chedinhtrung/RavenFC/images/5Vripples.jpg

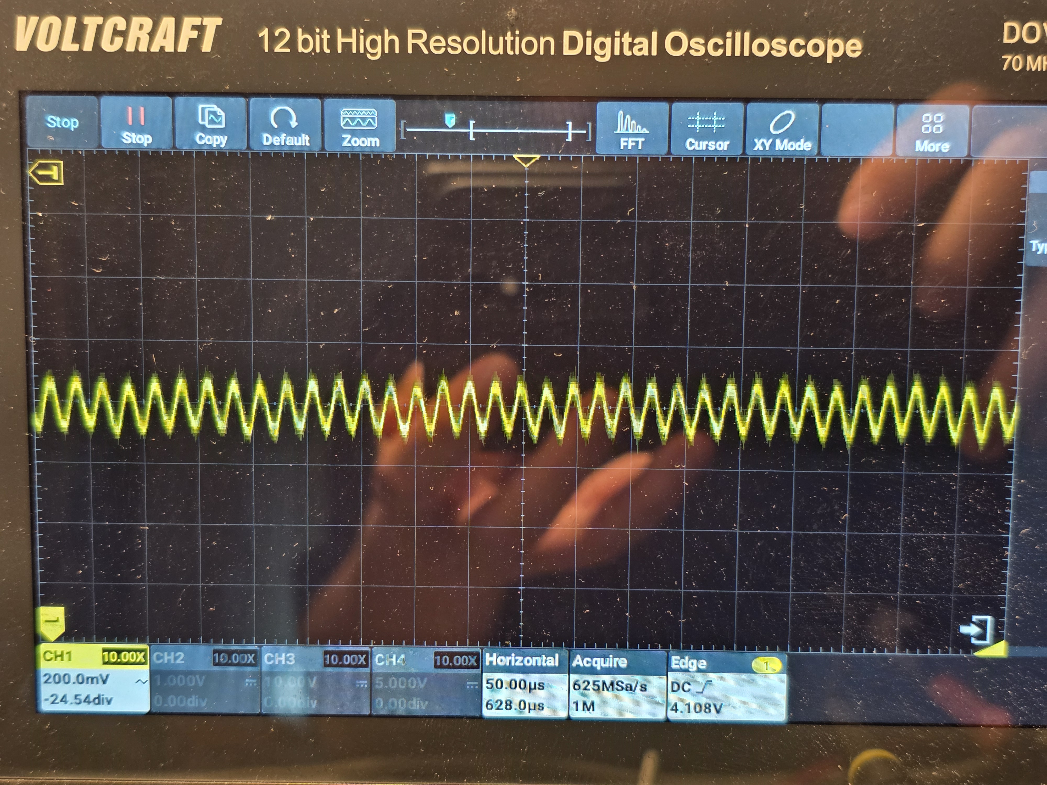
images/5Vripples.jpg
