chedinhtrung/RavenFC/images/fruitflypbc_back.jpg

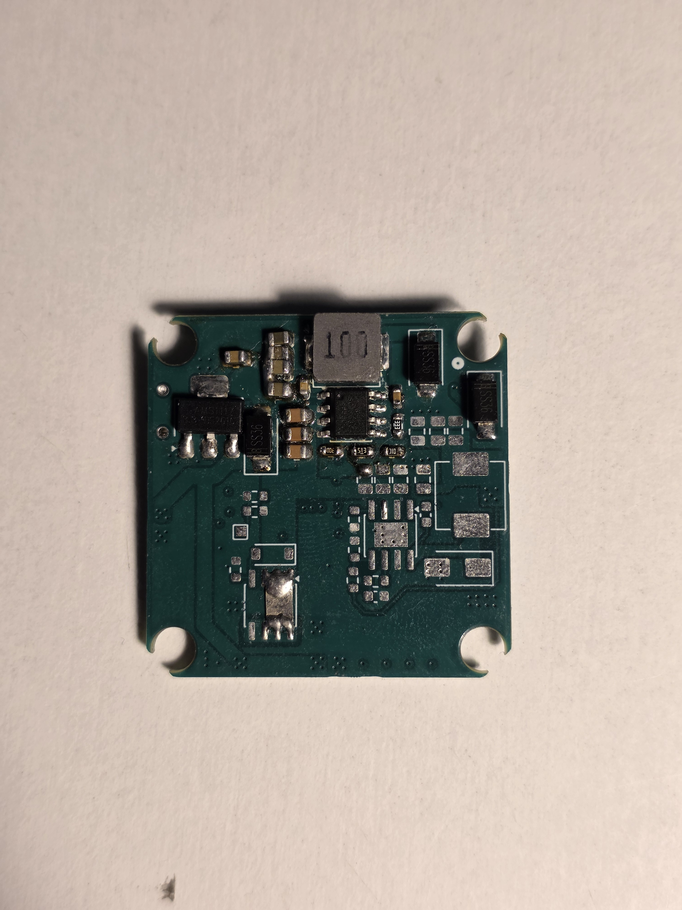
images/fruitflypbc_back.jpg
