chedinhtrung/RavenFC/images/fruitflypcb.jpg

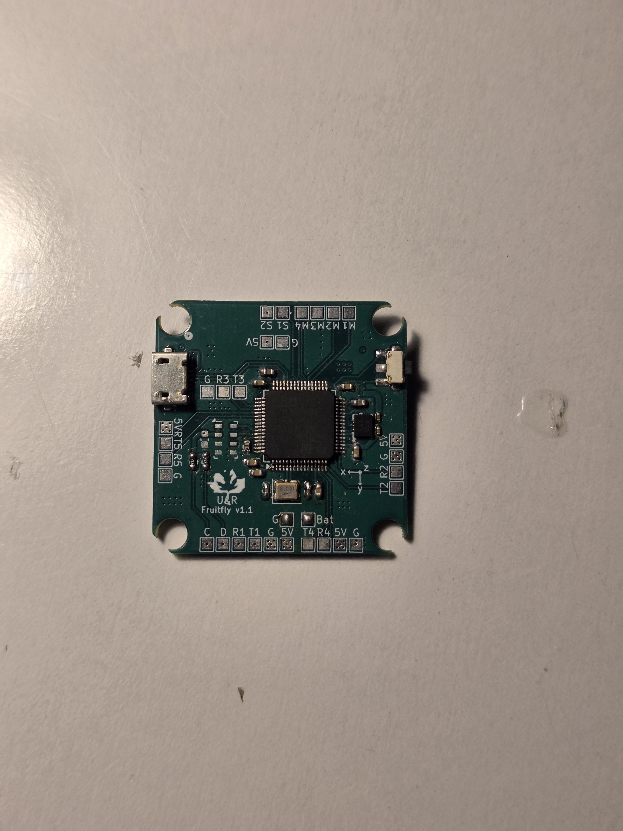
images/fruitflypcb.jpg
