chedinhtrung/RavenFC/RavenFC.csv

Reference | Qty | Value | Footprint | Source | Note
C1,C2,C3,C5,C6,C7,C21,C23,C28,C29,C31 | 11 | 100n | Capacitor_SMD:C_0603_1608Metric | https://de.aliexpress.com/item/1005006157020955.html?curPageLogUid=uuPveZMvu2K6 | Whole capacitor kit 0603 36 values
C4 | 1 | 1u | Capacitor_SMD:C_0603_1608Metric
C10,C20 | 2 | 3.3n | Capacitor_SMD:C_0603_1608Metric
C11,C12 | 2 | 18p | Capacitor_SMD:C_0603_1608Metric
C24,C25,C30 | 3 | 2.2u | Capacitor_SMD:C_0603_1608Metric
C13,C14,C15,C22,C27,C32,C33,C34 | 8 | 47u | Capacitor_SMD:C_0805_2012Metric | https://de.aliexpress.com/item/1005012405281784.html?curPageLogUid=aFX9kT3OdwsJ | at least 30V, whole capacitor kit 0805
C8,C9,C16,C17,C18,C19 | 6 | 10u | Capacitor_SMD:C_0805_2012Metric
C26 | 1 | 22u | Capacitor_SMD:C_0805_2012Metric
D1,D3 | 2 | B560C-13F | Diode_SMD:D_SMC | https://de.aliexpress.com/item/1005009912606629.html?mp=1 | Shottky fast recovery,
D2 | 1 | LED | LED_SMD:LED_0603_1608Metric | https://de.aliexpress.com/item/1005005180782404.html?curPageLogUid=Pe5OPY7OVnTa | 0603 package
D4 | 1 | D_Zener | Diode_SMD:D_SOD-123 | https://de.aliexpress.com/item/1005006882561155.html?curPageLogUid=dr5Xm8EKu7lk | 10V Zener
L1 | 1 | 8R2 | Inductor_SMD:L_Changjiang_FXL0630 |  | 0630 package
L2 | 1 | 8R2 | Inductor_SMD:L_Changjiang_FXL1040 |  | 1040 package
R1,R14 | 2 | 53.6k | Resistor_SMD:R_0603_1608Metric |  | Whole capacitor kit 0603 1k – 10M
R2,R8,R15 | 3 | 10k | Resistor_SMD:R_0603_1608Metric
R3,R10 | 2 | 10.2k | Resistor_SMD:R_0603_1608Metric
R4,R7 | 2 | 200k | Resistor_SMD:R_0603_1608Metric
R5,R6 | 2 | 33.2k | Resistor_SMD:R_0603_1608Metric
R9,R11 | 2 | 1k | Resistor_SMD:R_0603_1608Metric
R12,R13 | 2 | 4k7 | Resistor_SMD:R_0603_1608Metric
R16 | 1 | 100k | Resistor_SMD:R_0603_1608Metric
U1 | 1 | STM32H743VITx | Package_QFP:LQFP-100_14x14mm_P0.5mm
U2 | 1 | AMS1117-3.3 | Package_TO_SOT_SMD:SOT-223-3_TabPin2 | https://de.aliexpress.com/item/4000836586300.html?curPageLogUid=Eg1F4cGPgm6P
U3,U6 | 2 | SCT2650STE | Package_SO:SOIC-8-1EP_3.9x4.9mm_P1.27mm_EP2.41x3.3mm | https://de.aliexpress.com/item/1005008023636417.html?mp=1
U4 | 1 | MS5611-01BA | Package_LGA:LGA-8_3x5mm_P1.25mm | https://de.aliexpress.com/item/1005012426243078.html?mp=1
U7 | 1 | AO4407A | Package_SO:SO-8_3.9x4.9mm_P1.27mm | https://de.aliexpress.com/item/32795511535.html?mp=1
Y2 | 1 | 8MHz | Crystal:Crystal_SMD_3225-4Pin_3.2x2.5mm | https://de.aliexpress.com/item/1005006137821116.html?mp=1 | 12pF
