chedinhtrung/RavenFC/(commit log)

2026-08-28 first layout
    [RavenFC.kicad_pcb, RavenFC.kicad_sch]
2026-09-05 v1.2 fix unconnected BS
    [RavenFC-B_Cu.gbr, RavenFC-B_Mask.gbr, RavenFC-B_Paste.gbr, RavenFC-B_Silkscreen.gbr, RavenFC-Edge_Cuts.gbr, RavenFC-F_Cu.gbr, RavenFC-F_Mask.gbr, RavenFC-F_Paste.gbr]
2026-11-04 v1.3 improve ground returns
    [RavenFC-B_Cu.gbr, RavenFC-B_Mask.gbr, RavenFC-B_Paste.gbr, RavenFC-B_Silkscreen.gbr, RavenFC-Edge_Cuts.gbr, RavenFC-F_Cu.gbr, RavenFC-F_Mask.gbr, RavenFC-F_Paste.gbr]
